TahoeJacob/ReturnToSender/ReturnToSenderBOM.xlsb.xlsx

Return to sender BOM
Version | 1
Date | 2022-12-08
Part Name | Quantity | Unit Cost (NZD) | Cost (NZD) | Supplier Link | Notes
ESP Wroom32E-N16 | 1 | $6.07 | $6.07 | https://nz.mouser.com/ProductDetail/Espressif-Systems/ESP32-WROOM-32E-N16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
GPS | 1 | $19.40 | $19.40 | https://nz.mouser.com/ProductDetail/Quectel/L80RE-M37?qs=GedFDFLaBXGVxm6oyoODMA%3D%3D | Hardware Design Sheet: https://www.dragino.com/downloads/downloads/datasheet/other_vendors/L80-R/Quectel_L80-R_Hardware_Design_V1.2.pdf
LoRa Module | 1 | $31.58 | $31.58 | https://nz.mouser.com/ProductDetail/Murata-Electronics/CMWX1ZZABZ-091?qs=gTYE2QTfZfRtm%2FKTIJ%252BgzA%3D%3D
Board production | 1 | $6.00 | $6.00
IMU | 1 | $8.29 | $8.29 | https://nz.mouser.com/ProductDetail/STMicroelectronics/LSM6DSMTR?qs=dTJS0cRn7ogKkf7uVmbVmg%3D%3D
Buzzer | 1 | $2.67 | $2.67 | https://nz.mouser.com/ProductDetail/CUI-Devices/CMT-8503-90-SMT-TR?qs=P1JMDcb91o6FnIL1M3V%252BbQ%3D%3D
SMA Connector | 1 | 5.76 | $5.76 | https://nz.mouser.com/ProductDetail/Taoglas/EMPCB.SMAFSTJ.B.HT?qs=AL7xPqYNrmTeWSPxKT6oAw%3D%3D
Total cost per board (ex GST) |  |  | $79.77
Mechanical costs
Servo | 2 | $34.36 | $68.72 | https://nz.rs-online.com/web/p/servo-motors/7813046
