TahoeJacob/ReturnToSender/ReturnToSenderBOM.xlsx

Return to sender BOM
Version | 1
Date | 2022-12-08
Part Name | Quantity | Cost (NZD) | Supplier Link | Notes
ESP Wroom32E-N16 | 1 | $6.07 | https://nz.mouser.com/ProductDetail/Espressif-Systems/ESP32-WROOM-32E-N16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
GPS | 1 | $19.40 | https://nz.mouser.com/ProductDetail/Quectel/L80RE-M37?qs=GedFDFLaBXGVxm6oyoODMA%3D%3D | Hardware Design Sheet: https://www.dragino.com/downloads/downloads/datasheet/other_vendors/L80-R/Quectel_L80-R_Hardware_Design_V1.2.pdf
LoRa Module | 1 | $29.76 | https://nz.mouser.com/ProductDetail/Murata-Electronics/CMWX1ZZABZ-093?qs=gTYE2QTfZfRxVlR%2FlFm6Dg%3D%3D
Total cost per board |  | $55.23
