TahoeJacob/ReturnToSender/JacobGlideUnit/JacobGlideUnit.pdf

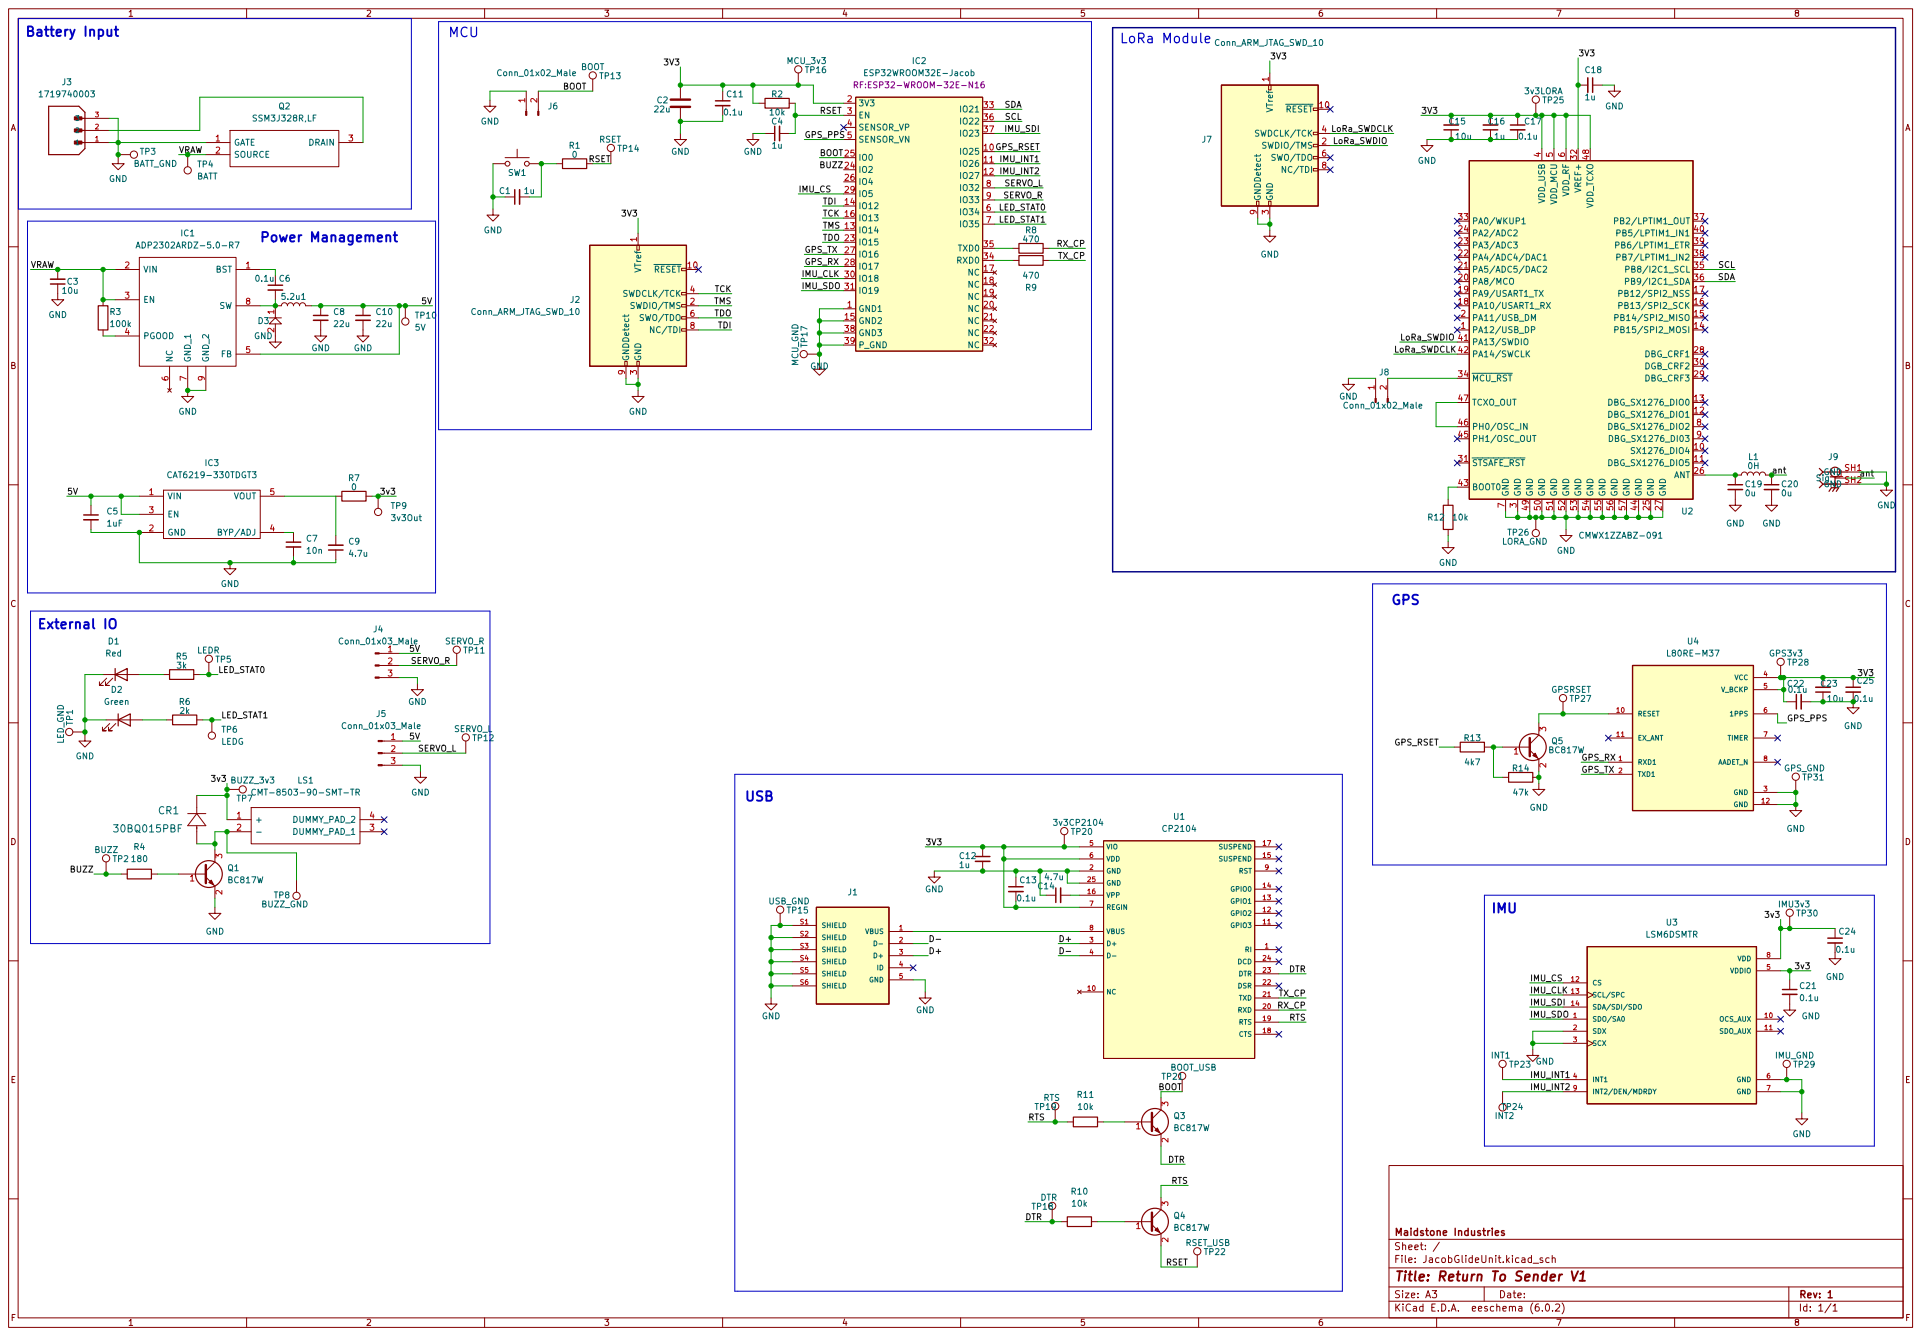
[picture p1: page 1]

3 SWDCLK/TCK 4 SWO/TDO 6 NC/TDI 8 GNDDetect 9

5 GND 50 GND 51 GND 52 GND 53 GND 54 GND 55 GND 56 GND 57 VDD_RF

File: JacobGlideUnit.kicad_sch Sheet: / Maidstone Industries

Id: 1/1 Title: Return To Sender V1
