TahoeJacob/ReturnToSender/JacobGlideUnit/JacobGlideUnit.kicad_sch

## KiCad design JacobGlideUnit/JacobGlideUnit.kicad_sch (2022-12-21, an earlier design)

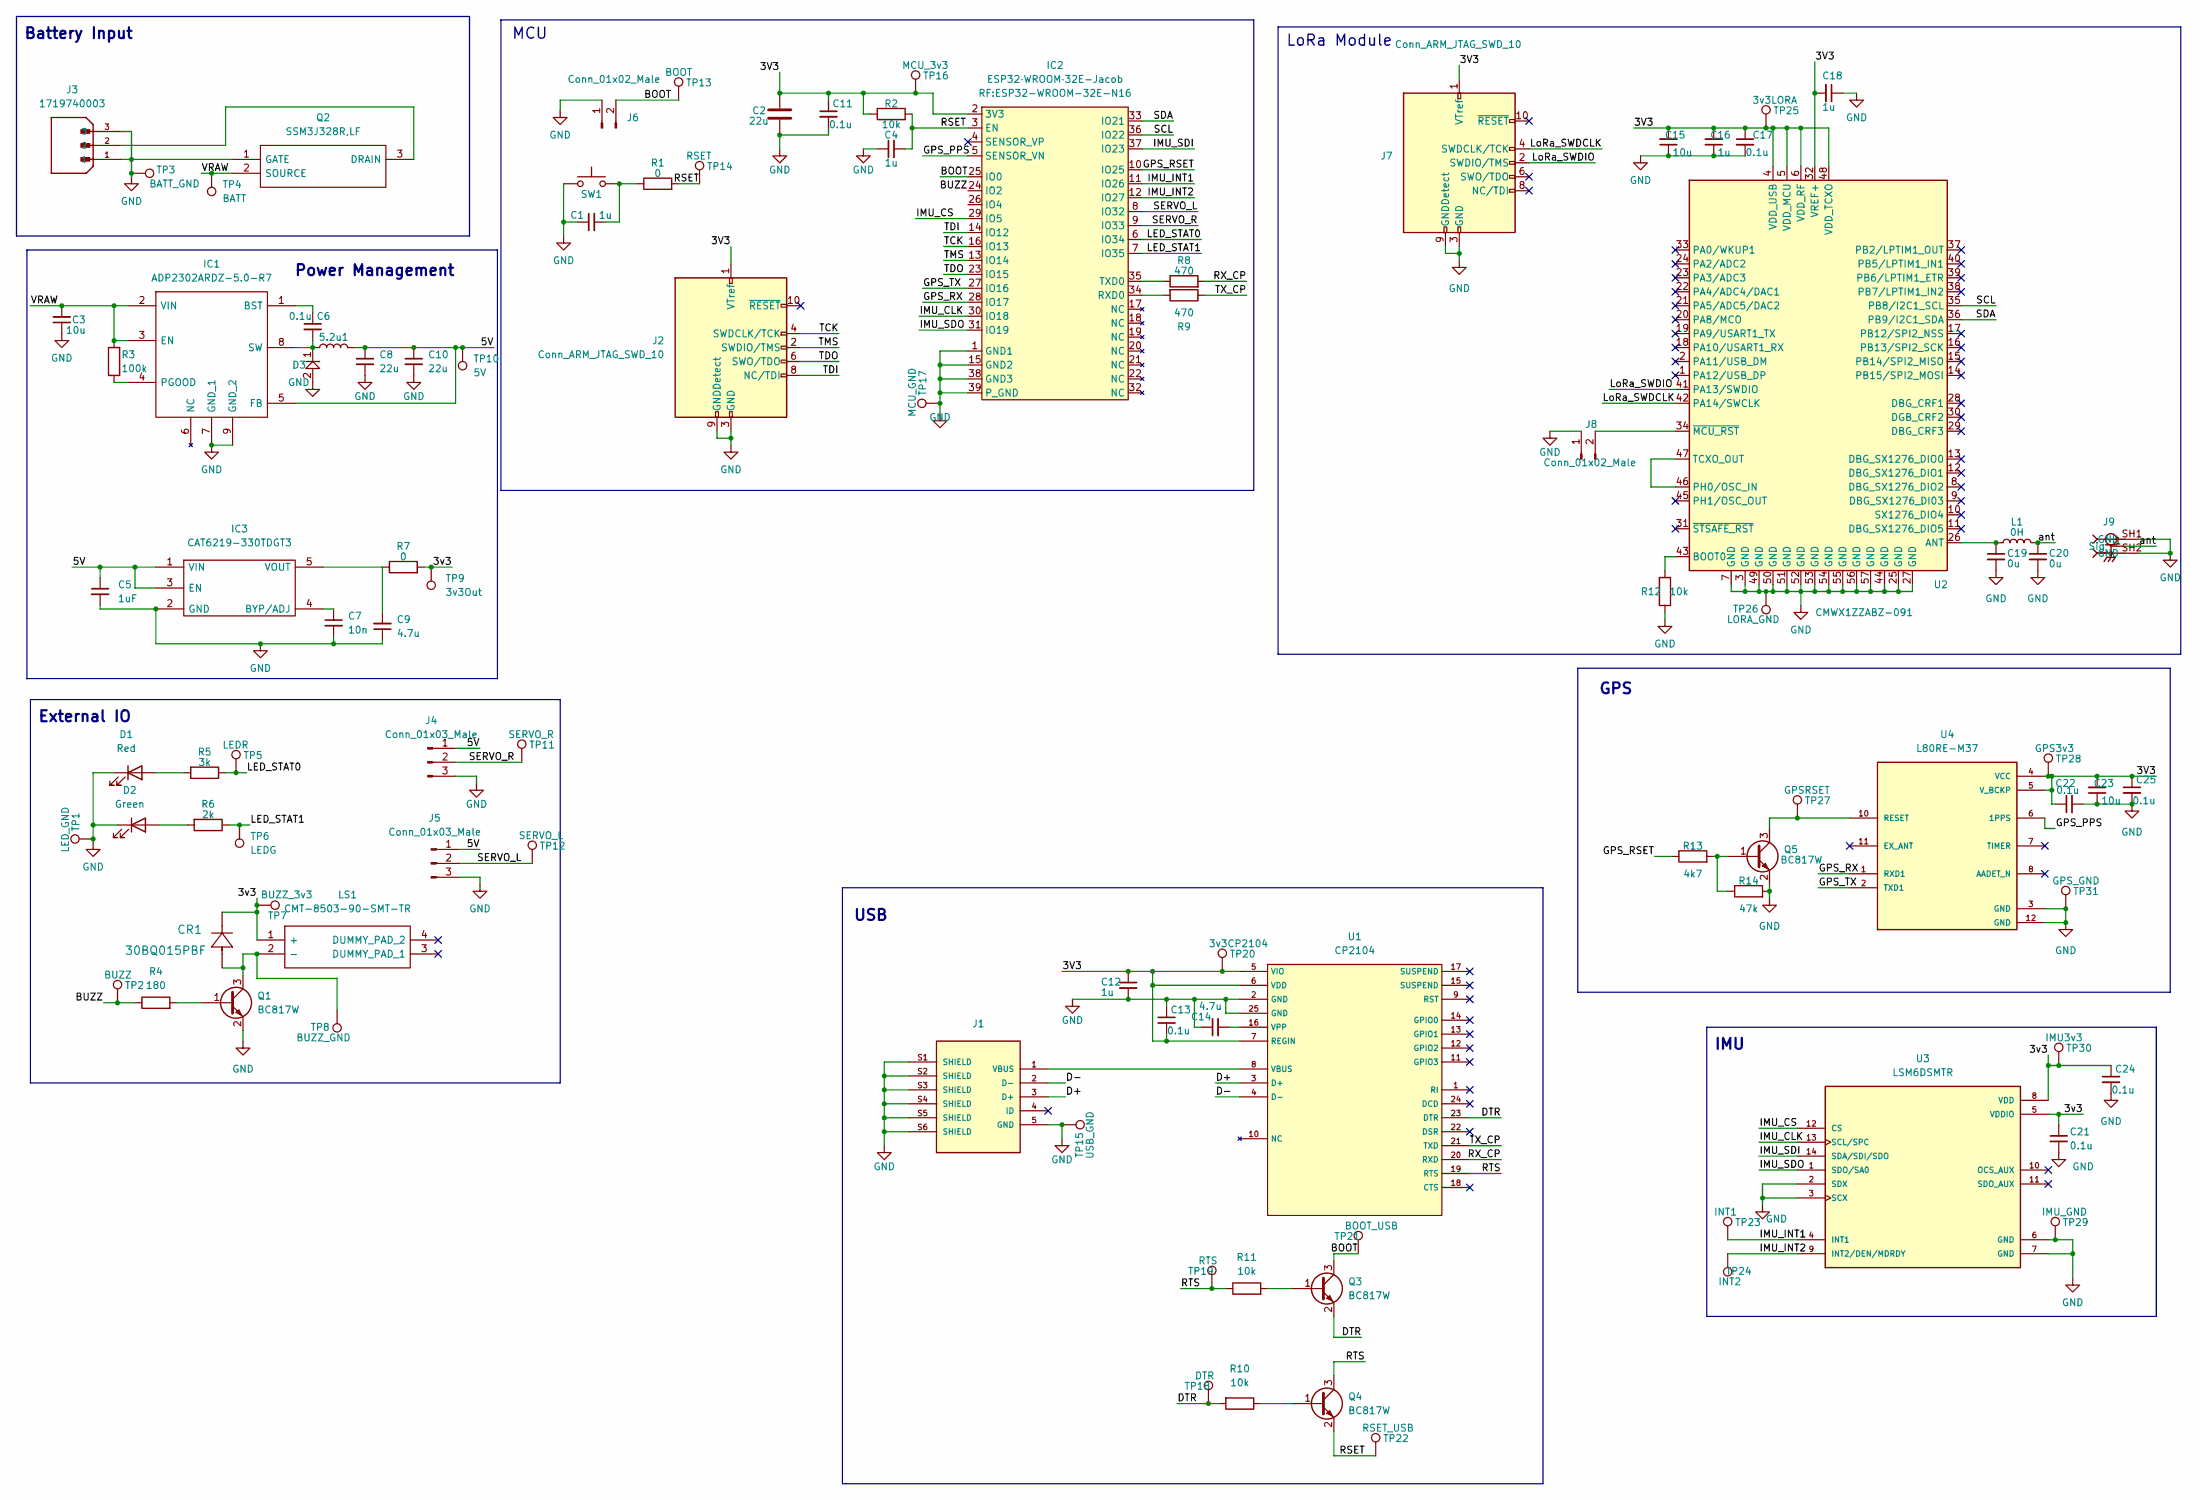
[picture p2: schematic JacobGlideUnit.kicad_sch]

Parts:
5.2u1: CDRH104R
C1, C16, C18: 1u; C_0603_1608Metric
C2, C8, C10: 22u; C_1206_3216Metric_Pad1.33x1.80mm_HandSolder
C3, C15, C23: 10u; C_0805_2012Metric_Pad1.18x1.45mm_HandSolder
C4, C12: 1u; C_0603_1608Metric_Pad1.08x0.95mm_HandSolder
C5: 1uF; C_0603_1608Metric_Pad1.08x0.95mm_HandSolder
C6, C11, C13, C17, C21, C22, C24, C25: 0.1u; C_0603_1608Metric_Pad1.08x0.95mm_HandSolder
C7: 10n; C_0603_1608Metric_Pad1.08x0.95mm_HandSolder
C9: 4.7u; C_0603_1608Metric_Pad1.08x0.95mm_HandSolder
C14: 4.7u; C_0805_2012Metric_Pad1.18x1.45mm_HandSolder
C19, C20: 0u; C_0603_1608Metric_Pad1.08x0.95mm_HandSolder
CR1: 30BQ015PBF
D1: Red; LED_0603_1608Metric_Pad1.05x0.95mm_HandSolder
D2: Green; LED_0603_1608Metric_Pad1.05x0.95mm_HandSolder
D3: MBRS330T3G; DIOM7958X256N; Mouser Part Number 863-MBRS330T3G
IC1: ADP2302ARDZ-5.0-R7; SOIC127P600X175-9N; Mouser Part Number 584-ADP2302ARDZ5.0R7
IC2: ESP32­WROOM­32E-Jacob; ESP32-WROOM-32E-N16
IC3: CAT6219-330TDGT3; SOT95P280X100-5N; Mouser Part Number 698-CAT6219-330TD-G
J1: 10118194-0001LF; AMPHENOL_10118194-0001LF
J2, J7: Conn_ARM_JTAG_SWD_10; PinHeader_2x05_P1.27mm_Vertical
J3: 1719740003; MOLEX_1719740003; PARTREV A6
J4, J5: Conn_01x03_Male; PinHeader_1x03_P2.54mm_Vertical
J6, J8: Conn_01x02_Male; PinHeader_1x02_P2.54mm_Vertical
J9: EMPCB.SMAFSTJ.B.HT; TAOGLAS_EMPCB.SMAFSTJ.B.HT
L1: 0H; L_0603_1608Metric_Pad1.05x0.95mm_HandSolder
LS1: CMT-8503-90-SMT-TR; CMT850390SMTTR; Mouser Part Number 490-CMT-8503-90SMTTR
Q1, Q3, Q4, Q5: BC817W; SOT-323_SC-70
Q2: SSM3J328R,LF; SOTFL95P240X88-3N; Mouser Part Number 757-SSM3J328RLF
R1, R7: 0; R_0603_1608Metric_Pad0.98x0.95mm_HandSolder
R2, R10, R11, R12: 10k; R_0603_1608Metric_Pad0.98x0.95mm_HandSolder
R3: 100k; R_0603_1608Metric_Pad0.98x0.95mm_HandSolder
R4: 180; R_0603_1608Metric_Pad0.98x0.95mm_HandSolder
R5: 3k; R_0603_1608Metric_Pad0.98x0.95mm_HandSolder
R6: 2k; R_0603_1608Metric_Pad0.98x0.95mm_HandSolder
R8, R9: 470; R_0603_1608Metric_Pad0.98x0.95mm_HandSolder
R13: 4k7; R_0603_1608Metric_Pad0.98x0.95mm_HandSolder
R14: 47k; R_0603_1608Metric_Pad0.98x0.95mm_HandSolder
SW1: SW_Push; KSR211G_Switch_Jacob
TP1: LED_GND; TestPoint_Pad_2.0x2.0mm
TP2: BUZZ; TestPoint_Pad_2.0x2.0mm
TP3: BATT_GND; TestPoint_Pad_2.0x2.0mm
TP4: BATT; TestPoint_Pad_2.0x2.0mm
TP5: LEDR; TestPoint_Pad_2.0x2.0mm
TP6: LEDG; TestPoint_Pad_2.0x2.0mm
TP7: BUZZ_3v3; TestPoint_Pad_2.0x2.0mm
TP8: BUZZ_GND; TestPoint_Pad_2.0x2.0mm
TP9: 3v3Out; TestPoint_Pad_2.0x2.0mm
TP10: 5V; TestPoint_Pad_2.0x2.0mm
TP11: SERVO_R; TestPoint_Pad_2.0x2.0mm
TP12: SERVO_L; TestPoint_Pad_2.0x2.0mm
TP13: BOOT; TestPoint_Pad_2.0x2.0mm
TP14: RSET; TestPoint_Pad_2.0x2.0mm
TP15: USB_GND; TestPoint_Pad_2.0x2.0mm
TP16: MCU_3v3; TestPoint_Pad_2.0x2.0mm
TP17: MCU_GND; TestPoint_Pad_2.0x2.0mm
TP18: DTR; TestPoint_Pad_2.0x2.0mm
TP19: RTS; TestPoint_Pad_2.0x2.0mm
TP20: 3v3CP2104; TestPoint_Pad_2.0x2.0mm
TP21: BOOT_USB; TestPoint_Pad_2.0x2.0mm
TP22: RSET_USB; TestPoint_Pad_2.0x2.0mm
TP23: INT1; TestPoint_Pad_2.0x2.0mm
TP24: INT2; TestPoint_Pad_2.0x2.0mm
TP25: 3v3LORA; TestPoint_Pad_2.0x2.0mm
TP26: LORA_GND; TestPoint_Pad_2.0x2.0mm
TP27: GPSRSET; TestPoint_Pad_2.0x2.0mm
TP28: GPS3v3; TestPoint_Pad_2.0x2.0mm
TP29: IMU_GND; TestPoint_Pad_2.0x2.0mm
TP30: IMU3v3; TestPoint_Pad_2.0x2.0mm
TP31: GPS_GND; TestPoint_Pad_2.0x2.0mm
U1: CP2104; QFN50P400X400X80-25N-D
U2: CMWX1ZZABZ-091; CMWX1ZZABZ
U3: LSM6DSMTR; PQFN50P300X250X86-14N; PARTREV Rev 7
U4: L80RE-M37; XCVR_L80RE-M37

Connections:
3v3: C2.1, C11.1, C12.1, C13.2, C15.2, C16.2, C17.1, C18.2, C21.1, C22.1, C23.2, C24.1, C25.1, CR1.1, IC2.2 (3V3), J2.1 (VTref), J7.1 (VTref), LS1.1 (+), R2.1, R7.2, TP7.1, TP9.1, TP16.1, TP20.1, TP25.1, TP28.1, TP30.1, U1.5 (VIO), U1.6 (VDD), U1.7 (REGIN), U2.4 (VDD_USB), U2.5 (VDD_MCU), U2.6 (VDD_RF), U2.32 (VREF+), U2.48 (VDD_TCXO), U3.5 (VDDIO), U3.8 (VDD), U4.4 (VCC), U4.5 (V_BCKP)
5V: 5.2u1.2, C5.1, C8.1, C10.1, IC1.5 (FB), IC3.1 (VIN), IC3.3 (EN), J4.1, J5.1, TP10.1
BOOT: IC2.25 (IO0), J6.2, Q3.3 (C), TP13.1, TP21.1
BUZZ: IC2.24 (IO2), R4.1, TP2.1
D+: J1.3 (D+), U1.3 (D+)
D-: J1.2 (D-), U1.4 (D-)
DTR: Q3.2 (E), R10.2, TP18.1, U1.23 (DTR)
GND: C1.1, C2.2, C3.1, C4.1, C5.2, C7.2, C8.2, C9.1, C10.2, C11.2, C12.2, C13.1, C14.1, C15.1, C16.1, C17.2, C18.1, C19.2, C20.2, C21.2, C22.2, C23.1, C24.2, C25.2, D1.1 (K), D2.1 (K), D3.2, IC1.7 (GND_1), IC1.9 (GND_2), IC2.1 (GND1), IC2.15 (GND2), IC2.38 (GND3), IC2.39 (P_GND), IC3.2 (GND), J1.5 (GND), J1.S1 (SHIELD), J1.S2 (SHIELD), J1.S3 (SHIELD), J1.S4 (SHIELD), J1.S5 (SHIELD), J1.S6 (SHIELD), J2.3 (GND), J2.5 (GND), J2.9 (GNDDetect), J3.1, J3.3, J4.3, J5.3, J6.1, J7.3 (GND), J7.5 (GND), J7.9 (GNDDetect), J8.1, J9.SH1 (GND), J9.SH2 (GND), Q1.2 (E), Q2.1 (GATE), Q5.2 (E), R12.1, R14.2, SW1.1, TP1.1, TP3.1, TP15.1, TP17.1, TP26.1, TP29.1, TP31.1, U1.2 (GND), U1.25 (GND), U2.3 (GND), U2.7 (GND), U2.25 (GND), U2.27 (GND), U2.44 (GND), U2.49 (GND), U2.50 (GND), U2.51 (GND), U2.52 (GND), U2.53 (GND), U2.54 (GND), U2.55 (GND), U2.56 (GND), U2.57 (GND), U3.2 (SDX), U3.3 (SCX), U3.6 (GND), U3.7 (GND), U4.3 (GND), U4.12 (GND)
GPS_PPS: IC2.5 (SENSOR_VN), U4.6 (1PPS)
GPS_RSET: IC2.10 (IO25), R13.1
GPS_RX: IC2.28 (IO17), U4.1 (RXD1)
GPS_TX: IC2.27 (IO16), U4.2 (TXD1)
IMU_CLK: IC2.30 (IO18), U3.13 (SCL/SPC)
IMU_CS: IC2.29 (IO5), U3.12 (CS)
IMU_INT1: IC2.11 (IO26), TP23.1, U3.4 (INT1)
IMU_INT2: IC2.12 (IO27), TP24.1, U3.9 (INT2/DEN/MDRDY)
IMU_SDI: IC2.37 (IO23), U3.14 (SDA/SDI/SDO)
IMU_SDO: IC2.31 (IO19), U3.1 (SDO/SA0)
LED_STAT0: IC2.6 (IO34), R5.1, TP5.1
LED_STAT1: IC2.7 (IO35), R6.1, TP6.1
LoRa_SWDCLK: J7.4 (SWDCLK/TCK), U2.42 (PA14/SWCLK)
LoRa_SWDIO: J7.2 (SWDIO/TMS), U2.41 (PA13/SWDIO)
unnamed: 5.2u1.1, C6.2, D3.1, IC1.8 (SW)
unnamed: C1.2, R1.1, SW1.2
unnamed: C6.1, IC1.1 (BST)
unnamed: C7.1, IC3.4 (BYP/ADJ)
unnamed: C9.2, IC3.5 (VOUT), R7.1
unnamed: C14.2, U1.16 (VPP)
unnamed: C19.1, L1.1, U2.26 (ANT)
unnamed: CR1.2, LS1.2 (-), Q1.3 (C), TP8.1
unnamed: D1.2 (A), R5.2
unnamed: D2.2 (A), R6.2
unnamed: IC1.4 (PGOOD), R3.1
unnamed: IC2.34 (RXD0), R9.2
unnamed: IC2.35 (TXD0), R8.1
unnamed: J1.1 (VBUS), U1.8 (VBUS)
unnamed: J3.2, Q2.3 (DRAIN)
unnamed: J8.2, U2.34 (~MCU_RST)
unnamed: Q1.1 (B), R4.2
unnamed: Q3.1 (B), R11.2
unnamed: Q4.1 (B), R10.1
unnamed: Q5.1 (B), R13.2, R14.1
unnamed: Q5.3 (C), TP27.1, U4.10 (RESET)
unnamed: R12.2, U2.43 (BOOT0)
unnamed: U2.46 (PH0/OSC_IN), U2.47 (TCXO_OUT)
RSET: C4.2, IC2.3 (EN), Q4.2 (E), R1.2, R2.2, TP14.1, TP22.1
RTS: Q4.3 (C), R11.1, TP19.1, U1.19 (RTS)
RX_CP: R8.2, U1.20 (RXD)
SCL: IC2.36 (IO22), U2.35 (PB8/I2C1_SCL)
SDA: IC2.33 (IO21), U2.36 (PB9/I2C1_SDA)
SERVO_L: IC2.8 (IO32), J5.2, TP12.1
SERVO_R: IC2.9 (IO33), J4.2, TP11.1
TCK: IC2.16 (IO13), J2.4 (SWDCLK/TCK)
TDI: IC2.14 (IO12), J2.8 (NC/TDI)
TDO: IC2.23 (IO15), J2.6 (SWO/TDO)
TMS: IC2.13 (IO14), J2.2 (SWDIO/TMS)
TX_CP: R9.1, U1.21 (TXD)
VRAW: C3.2, IC1.2 (VIN), IC1.3 (EN), Q2.2 (SOURCE), R3.2, TP4.1
ant: C20.1, J9.1 (Sig), L1.2

Notes on the sheet:
Power Management
Battery Input
External IO
GPS
IMU
MCU
USB
LoRa Module
