TahoeJacob/ReturnToSender/(commit log)

2022-12-21 Transferred Desktop to Git
    Transferred local to git
    [10118194-0001LF.step, 1719740003.step, ADP2302ARDZ-5.0-R7.SchLib, ADP2302ARDZ-5.0-R7.stp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]
2022-12-21 File Structure Organization
    Organized footprints into separate folder
    [JacobGlideUnit.kicad_sch]
